AndreasBakke/DIC-project/README.md

# Design of Integrated Circuits Project
Design of Integrated Circuits 2021 project

Verilog files may be read in the folder /project/verilog

SPICE files are found in the folder /project/spice

Andreas S. Bakke & Øyvind M. Bjaerum
