AndreasBakke/DIC-project/project/verilog/pixelTopBRA.jpg

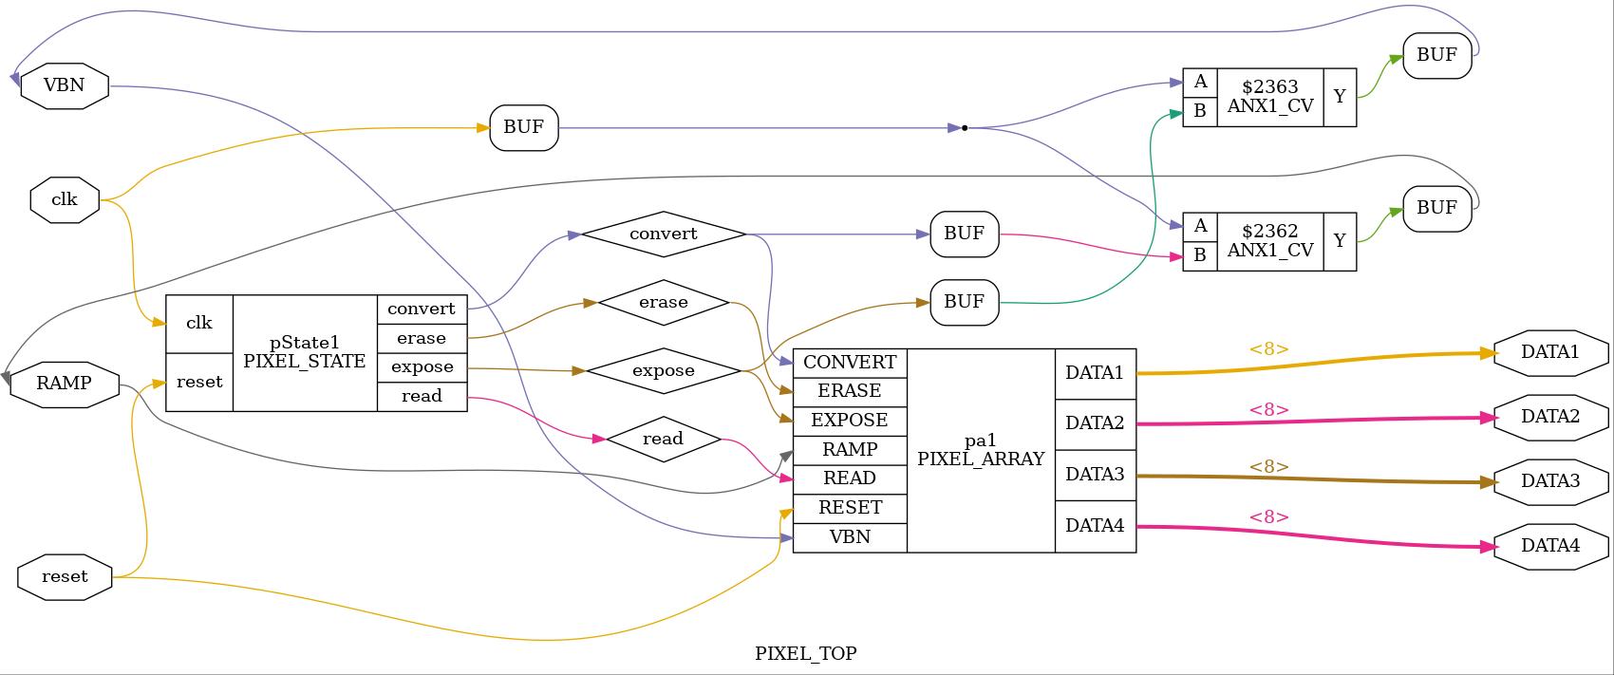
project/verilog/pixelTopBRA.jpg
