AndreasBakke/DIC-project/project/spice/pixelSensor.cir

* Pixel sensor
**********************************************************************
**        Copyright (c) 2021 Carsten Wulff Software, Norway
** *******************************************************************
** Created       : wulff at 2021-7-22
** *******************************************************************
**  The MIT License (MIT)
**
**  Permission is hereby granted, free of charge, to any person obtaining a copy
**  of this software and associated documentation files (the "Software"), to deal
**  in the Software without restriction, including without limitation the rights
**  to use, copy, modify, merge, publish, distribute, sublicense, and/or sell
**  copies of the Software, and to permit persons to whom the Software is
**  furnished to do so, subject to the following conditions:
**
**  The above copyright notice and this permission notice shall be included in all
**  copies or substantial portions of the Software.
**
**  THE SOFTWARE IS PROVIDED "AS IS", WITHOUT WARRANTY OF ANY KIND, EXPRESS OR
**  IMPLIED, INCLUDING BUT NOT LIMITED TO THE WARRANTIES OF MERCHANTABILITY,
**  FITNESS FOR A PARTICULAR PURPOSE AND NONINFRINGEMENT. IN NO EVENT SHALL THE
**  AUTHORS OR COPYRIGHT HOLDERS BE LIABLE FOR ANY CLAIM, DAMAGES OR OTHER
**  LIABILITY, WHETHER IN AN ACTION OF CONTRACT, TORT OR OTHERWISE, ARISING FROM,
**  OUT OF OR IN CONNECTION WITH THE SOFTWARE OR THE USE OR OTHER DEALINGS IN THE
**  SOFTWARE.
**
**********************************************************************
.include comp.cir
.include sensor.cir
.include memory.cir


.SUBCKT PIXEL_SENSOR VBN1 VRAMP VRESET ERASE EXPOSE READ
+ DATA_7 DATA_6 DATA_5 DATA_4 DATA_3 DATA_2 DATA_1 DATA_0 VDD VSS

XS1 VRESET VSTORE ERASE EXPOSE VDD VSS SENSOR

XC1 VCMP_OUT VSTORE VRAMP VBN1 VDD VSS COMP

XM1 READ VCMP_OUT DATA_7 DATA_6 DATA_5 DATA_4 DATA_3 DATA_2 DATA_1 DATA_0 VSS MEMORY

.ENDS
