AndreasBakke/DIC-project/project/verilog/pixelSensor.v

`timescale 1 ns / 1 ps
//====================================================================
//        Copyright (c) 2021 Carsten Wulff Software, Norway
// ===================================================================
// Created       : wulff at 2021-7-21
// ===================================================================
//  The MIT License (MIT)
//
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
//====================================================================

//----------------------------------------------------------------
// Model of pixel sensor, including
//  - Reset
//  - The sensor
//  - Comparator
//  - Memory latch
//  - Readout of latched value
//----------------------------------------------------------------
module PIXEL_SENSOR
  (
   input logic      VBN1,
   input logic      RAMP,
   input logic      ERASE,
   input logic      EXPOSE,
   input logic      READ,
   inout [7:0] DATA

   );

   parameter real             v_erase = 1.2;
   parameter real             lsb = v_erase/255; //1/255 av basespenning.
   parameter real   dv_pixel = 0.5; //photodiode current

   real             tmp;
   logic            cmp;
   real             adc;

   logic [7:0]      p_data;

   //----------------------------------------------------------------
   // ERASE
   //----------------------------------------------------------------
   // Reset the pixel value on pixRst
   always @(ERASE) begin
      tmp = v_erase;
      p_data = 0;
      cmp  = 0;
      adc = 0;
   end

   //----------------------------------------------------------------
   // SENSOR
   //----------------------------------------------------------------
   // Use bias to provide a clock for integration when exposing
   always @(posedge VBN1) begin
      if(EXPOSE)//Når vi exposer øker tmp gradvis. helt til et gitt nivå.
         tmp = tmp - dv_pixel*lsb; //Vår "input i fig6"
   end

   //----------------------------------------------------------------
   // Comparator
   //----------------------------------------------------------------
   // Use ramp to provide a clock for ADC conversion, assume that ramp
   // and DATA are synchronous
   always @(posedge RAMP)begin //Så øker vi adc gradvis helt til vi når input
      adc = adc + lsb; //Vi øker adc med Lsb. Som er 1/255 av basespenningen (slik at vi kan gå over et helt minne under exposure og integration)
      if(adc > tmp)//Stopper når adc (vår liksomRamp) blir høyere enn input tmp 
        cmp <= 1;//Da stopper vi å lagre data.
   end

   //----------------------------------------------------------------
   // Memory latch
   //----------------------------------------------------------------
   always_comb  begin
      if(!cmp) begin
         p_data = DATA;//Lagrer data (som vi får inn fra tb) i p_data helt til CMP=1 - da latches verdien i p_data
      end
   end

   //----------------------------------------------------------------
   // Readout
   //----------------------------------------------------------------
   // Assign data to bus when pixRead = 0
   assign DATA = READ ? p_data : 8'bZ; //når vi leser henter vi ut latchet verdi p_data.

endmodule // re_control
