AndreasBakke/DIC-project/(commit log)

2021-11-10 Implemented reset test and fixed data
    [pixelArray.v, pixelState.v, pixelTop_tb.v]
2021-11-13 Fixed memcell testbench, now VG stores the right voltage when WRITE goes high, and the DMEM goes high when READ goes high, showing that the high bit is stored
2021-11-15 Working sensor with testbench
